burnsoftnet/Pool-Monitor/README.md

# Pool Monitor

Arduino Project to monitor PH and Temperature as well as outside temperature.  This project is put together from other Arduino Projects as well as some custom stuff that was lacking in the other projects.

## Resources:

**Pool Controller © GPL3+**

https://create.arduino.cc/projecthub/mmackes/pool-controller-8dfa69

**HOW TO SET UP THE DHT11 HUMIDITY SENSOR ON AN ARDUINO**

https://www.circuitbasics.com/how-to-set-up-the-dht11-humidity-sensor-on-an-arduino/

**Safepools.pH © LGPL**

https://create.arduino.cc/projecthub/safepools-ph/safepools-ph-408029

**DIY Benchtop pH Meter © CC BY-NC**

https://create.arduino.cc/projecthub/atlasscientific/diy-benchtop-ph-meter-e94fb4

## COMPONENTS AND SUPPLIES

- 1 x Arduino UNO Wifi Rev 2 ( https://www.amazon.com/gp/product/B07MK598QV/ref=ppx_yo_dt_b_asin_title_o08_s02?ie=UTF8&psc=1 ).
- 2 x E-Projects 10EP5144K70 4.7k Ohm Resistors, 1/4 W, 5% (Pack of 10) (https://www.amazon.com/E-Projects-4-7k-Resistors-Watt-Pieces/dp/B00EV20PF8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)
- 1 x HiLetgo 5pcs DHT11 Temperature Humidity Sensor Module Digital Temperature Humidity Sensor 3.3V-5V Humidity Measure Range 20%-95% Temperature Measure Range 0-50℃ Celsius with Dupont Wires ( https://www.amazon.com/gp/product/B01DKC2GQ0/ref=ppx_yo_dt_b_asin_title_o02_s01?ie=UTF8&psc=1 )
- 1 x Atlas Scientific Gravity Analog pH Kit
 ( https://www.amazon.com/gp/product/B07VN8SKR7/ref=ppx_yo_dt_b_search_asin_title?ie=UTF8&psc=1 )
- 1 x Gratury Junction Box, Hinged Transparent Cover Stainless Steel Clip IP67 Waterproof Plastic Enclosure for Electrical Project Includes Mounting Plate and Wall Bracket 220×170×110mm (8.6"×6.7"×4.3" TC)( https://www.amazon.com/gp/product/B0828387BM/ref=ppx_yo_dt_b_asin_title_o09_s00?ie=UTF8&psc=1 ) 
- Sunnytech 1pc 3w 9v 333ma Mini Solar Panel Module Solar System Solar Epoxy Cell Charger DIY B043 ( https://www.amazon.com/gp/product/B00P4W9UE6/ref=ppx_yo_dt_b_asin_title_o04_s00?ie=UTF8&psc=1 )
- DFROBOT 900mA MPPT Solar Panel Controller - Solar Power Manager Module for 5V Solar Panel - Support Solar and USB Charging ( https://www.amazon.com/gp/product/B07MML4YJV/ref=ppx_yo_dt_b_asin_title_o04_s01?ie=UTF8&psc=1 )
- 2pcs 3.7V 1100mAh Lithium Rechargable Battery 1S 3C Lipo Battery with Protection Board, Insulated Rubber Tape and Micro JST 1.25 Plug for Arduino Nodemcu ESP32 Development Board ( https://www.amazon.com/gp/product/B0867KDMY7/ref=ppx_yo_dt_b_asin_title_o04_s02?ie=UTF8&psc=1 )
- 1 x 10K Ohm Resistor - https://www.amazon.com/gp/product/B07QJB31M7/ref=ppx_yo_dt_b_search_asin_title?ie=UTF8&th=1
- 1 x 100k Ohm Resistor - https://www.amazon.com/gp/product/B07QK9793W/ref=ppx_yo_dt_b_search_asin_title?ie=UTF8&psc=1
- 1 x Cylewet 12Pcs 12mm Self-Locking Latching Push Button Switch - https://www.amazon.com/gp/product/B075VBV4QH/ref=ppx_yo_dt_b_search_asin_title?ie=UTF8&psc=1
- 1 x Photoresistor Photo Light Sensitive Resistor Light Dependent - https://www.amazon.com/eBoot-Photoresistor-Sensitive-Resistor-Dependent/dp/B01N7V536K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
- 1 x Waterproof Digital Temperature Sensor Single Line Smart Temperature Sensor Probe ( https://www.amazon.com/gp/product/B07VWTFZXC/ref=ppx_yo_dt_b_search_asin_title?ie=UTF8&psc=1 )
- 1 x uxcell 50 Pcs Red DIP Switch 1 Positions for Circuit Breadboards PCB ( https://www.amazon.com/gp/product/B07M9YJKQ6/ref=ppx_yo_dt_b_search_asin_title?ie=UTF8&psc=1 )
- 1 x PCB Board Prototype Board ( https://www.amazon.com/gp/product/B01N3161JP/ref=ppx_yo_dt_b_search_asin_title?ie=UTF8&psc=1 )
- 12 x Brass Standoff / Stainless Steel Screw Nut - Electronics-Salon Metric M2.5 Hex Male-Female Brass Standoff / Stainless Steel Screw Nut Assortment Kit, for Raspberry-Pi. Spacer 6mm 8mm 10mm 12mm 15mm 18mm 20mm 25mm, Nut M2.5, Screw M2.5 x 6mm.
- Jumper Wires ( https://www.amazon.com/gp/product/B08151TQHG/ref=ppx_yo_dt_b_search_asin_title?ie=UTF8&psc=1 )

## Build Cost

Below is a ruff estimate of the cost of materials to make this  pool monitor, this is not including any type of connectors or special wires that you might want to use to make it pretty or even the type of mounts to secure things in place.  But mostly a cost of all the materials listed above.

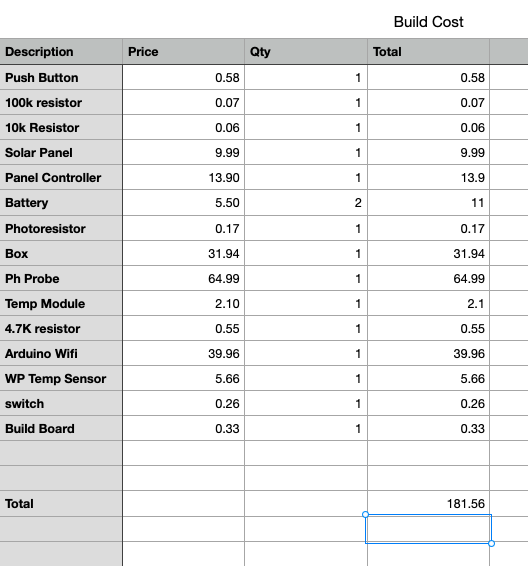
[picture p1: BuildCost.png]


## APPS AND ONLINE SERVICES

- Arduino IDE
- DallasTemperature ( https://github.com/milesburton/Arduino-Temperature-Control-Library/blob/master/DallasTemperature.h )

## Schematic

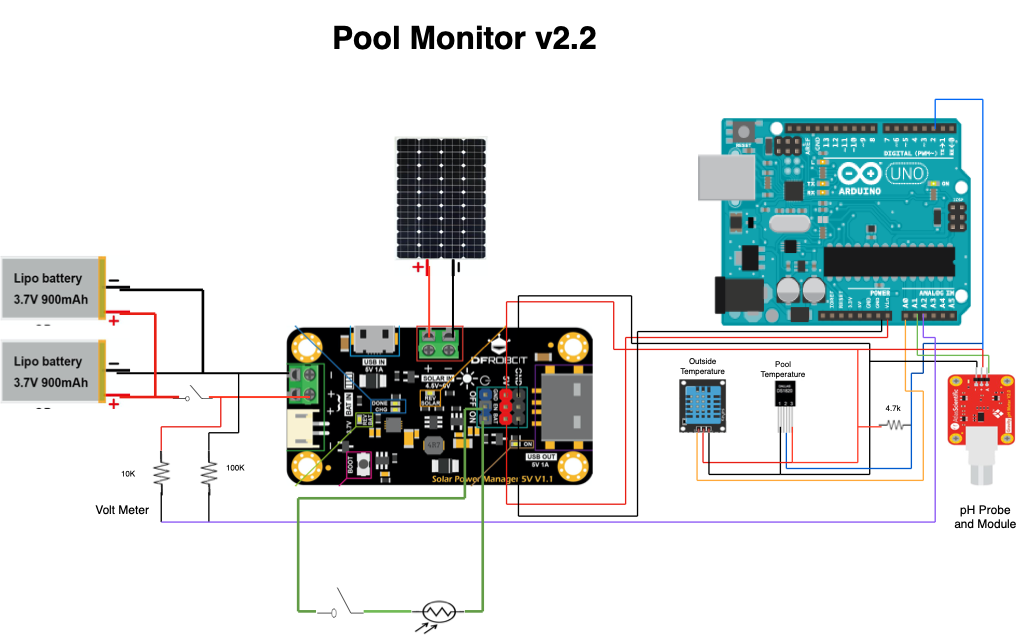
[picture p2: Schematic/PoolMonitor.png]


The Solar module and panel was added in version 2 along with a volt meter to monitor the battery status.  The Volt meter circuit has an on and off switch in case you needed to reboot everything without having to take a screw driver to it.  The Volt meter is independent and does not have to be hooked up to the Arduino, it will still pass the needed voltage to the solar module with the option to monitor the voltage from the mater.  Dis can also be disabled in the code by setting the GetVm to false.

## Web UI

There is nothing much to the web ui, it will just display the outside temperature, the outside humidity, the pool temperature and the pH Level.

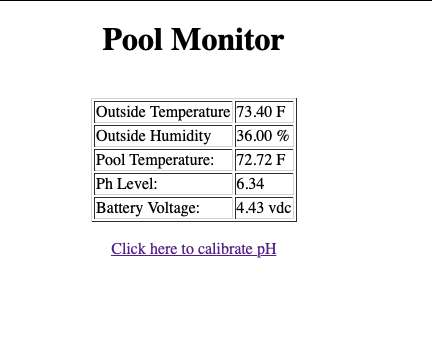
[picture p3: pictures/webui.png]


pH Calibration Page

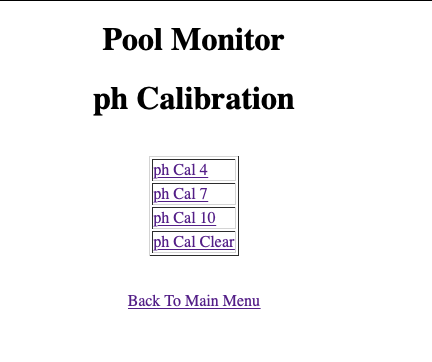
[picture p4: pictures/webui_cal.png]


## End Product

Version 2 of the finished project:

### Inside
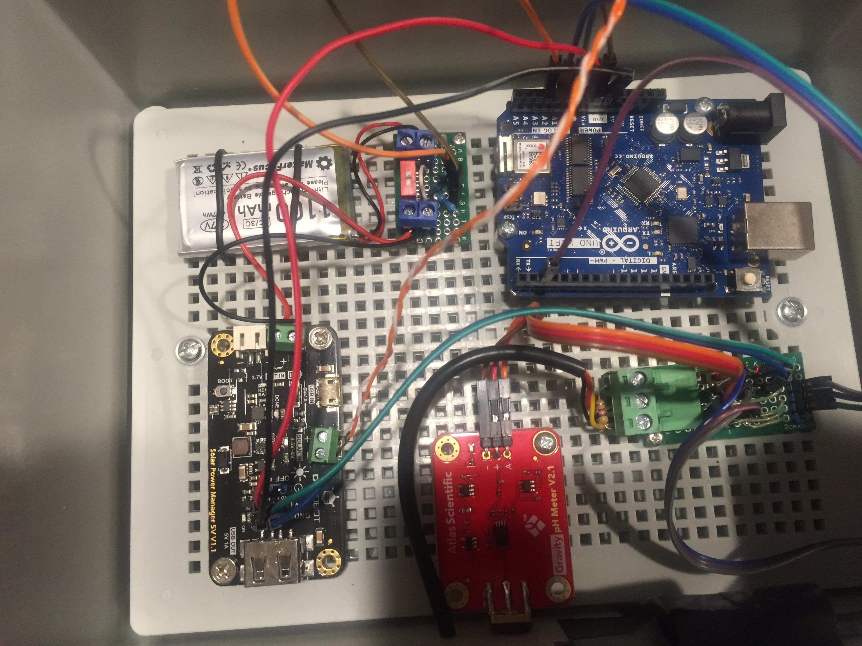
[picture p5: pictures/v2_inside.JPG]


### Outside Front

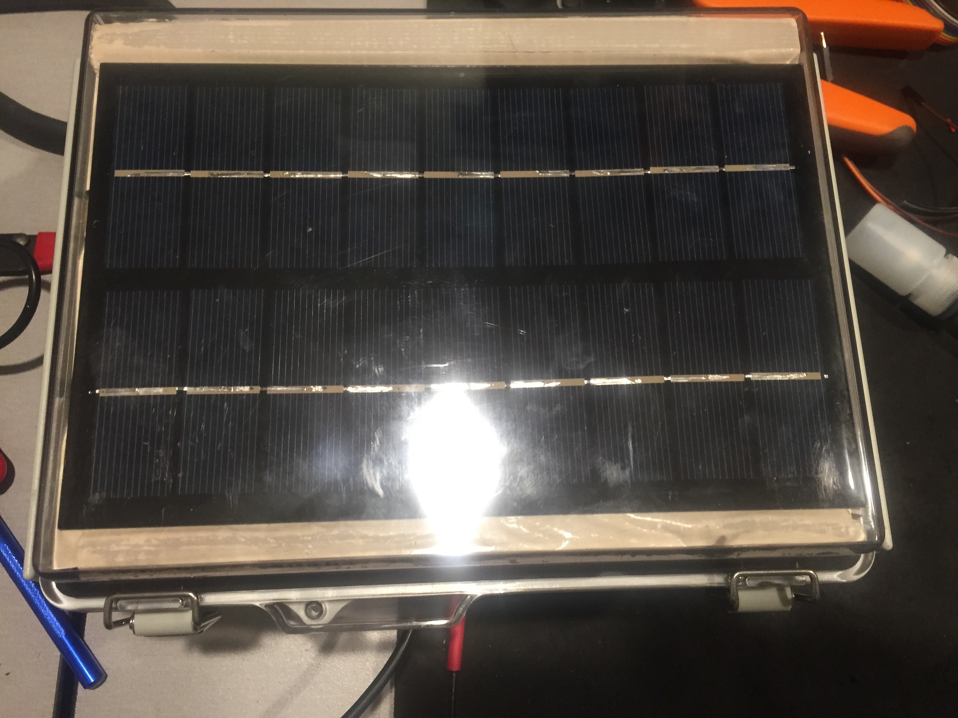
[picture p6: pictures/v2_front.JPG]


### Outside Bottom

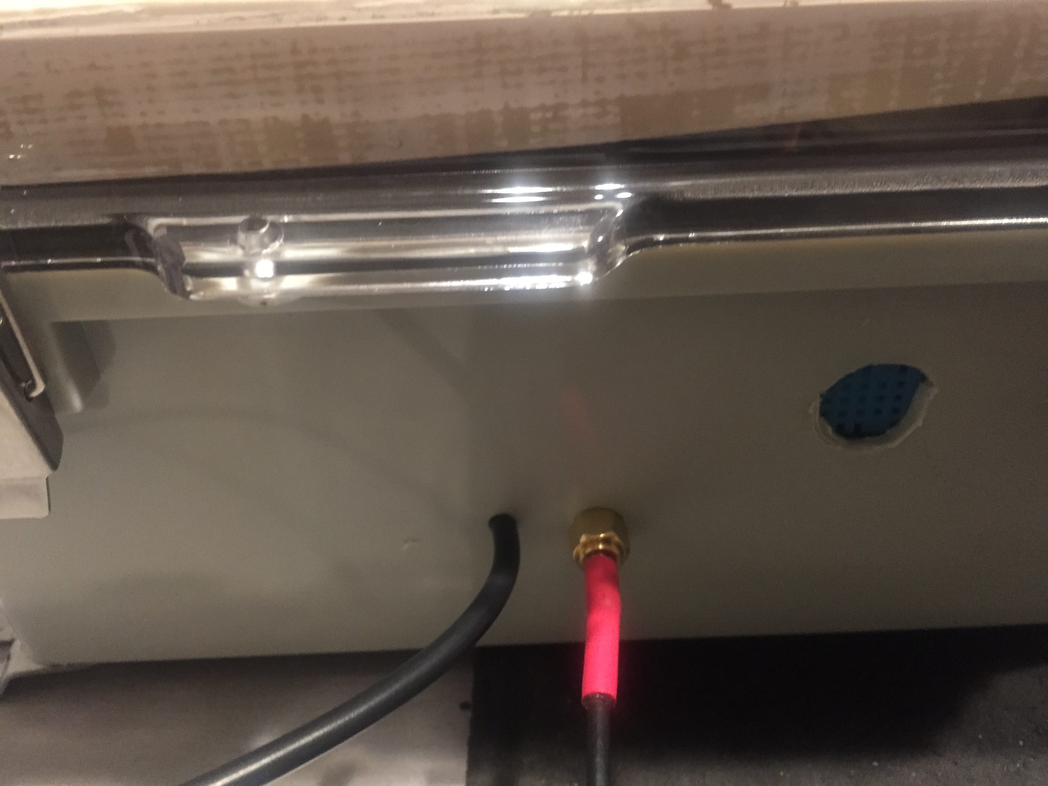
[picture p7: pictures/v2_bottom.JPG]
