burnsoftnet/Pool-Monitor/pictures/DS18B20.jpg

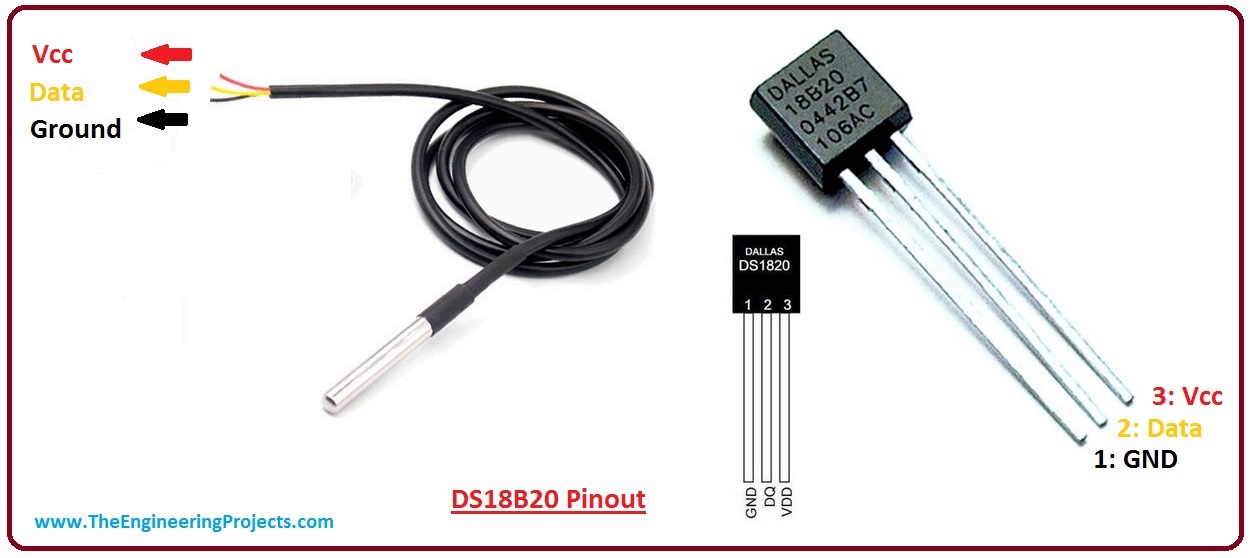
pictures/DS18B20.jpg
