burnsoftnet/Pool-Monitor/pictures/v1.JPG

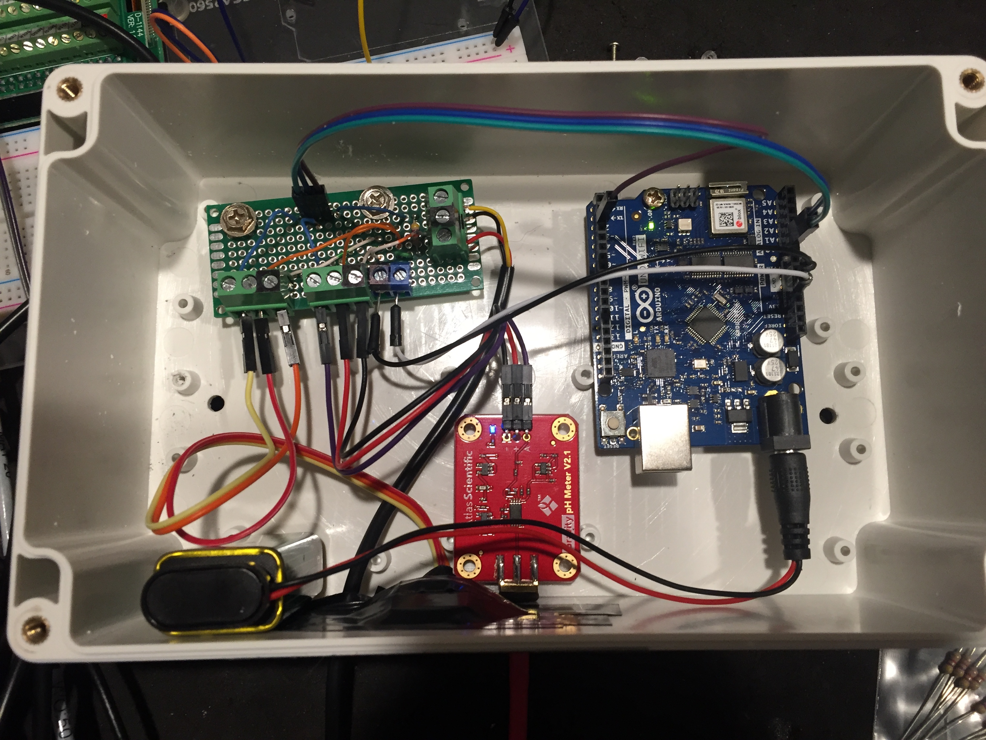
pictures/v1.JPG
