burnsoftnet/Pool-Monitor/(threads)

Thread 1 (2020-07-12):

Make Option to configure pH meter through Web UI

burnsoftnet, 2020-07-12:
Currently you can configure/ calibrate the pH meter through the serial interface, it would be better to do this through the Web UI just to reduce the amount of times that the box is opened, other than for currently the battery replacement.

Closed 2021-02-02.

Thread 2 (2020-07-12):

Update ReadMe

burnsoftnet, 2020-07-12:
Update the Read me file on everything needed to make this project:

- the final current version picture.
- Update the materials list
- Add assembly instructions

Closed 2021-01-04.

Thread 3 (2020-07-13):

Test How long the battery lasts

burnsoftnet, 2020-07-13:
This is a new battery operated project and with it controller extra functions, we need to test and see how long 1 battery would last

burnsoftnet, 2020-07-17:
Lasted for an hour after turning it back on.  going to try another batter to see if it last 7 hours straight

burnsoftnet, 2020-07-17:
Added new battery at 1640

Closed 2020-07-17.

Thread 4 (2020-07-13):

Solar Power Charger

burnsoftnet, 2020-07-13:
Add a solar power system to charge the batter when it's day light and to use the battery at night

burnsoftnet, 2020-07-23:
Mounted unit and turned on at 1740

Closed 2021-01-04.

Thread 5 (2020-07-13):

Internal Volt Meter

burnsoftnet, 2020-07-13:
Add an internal volt meter to the page so you can see how the battery is performing

Closed 2021-01-04.

Thread 8 (2021-02-04):

Increase Battery Capacity

burnsoftnet, 2021-02-04:
Increate Battery Capacity to last longer when the sun is not out

Closed 2021-02-04.

Thread 9 (2021-02-04):

Add Power and Solar Power Switch

burnsoftnet, 2021-02-04:
Add Power and Solar Power Switch to turn on and off the pool monitor

Closed 2021-02-04.

Thread 12 (2022-05-09):

Create Box for OLED

burnsoftnet, 2022-05-09:
Cut up and existing box or make something from the 3d printer

Thread 16 (2024-03-26):

Add Reset Option in Serial Menu

burnsoftnet, 2024-03-26:
Add the option to reboot the Arduino device from the serial command line.
