burnsoftnet/Pool-Monitor/ArduinoPoolMonitor/atlas_gravity/do_grav.h

/*
MIT License

Copyright (c) 2019 Atlas Scientific

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
THE SOFTWARE IS PROVIDED "AS IS", WITHOUT WARRANTY OF ANY KIND, EXPRESS OR
IMPLIED, INCLUDING BUT NOT LIMITED TO THE WARRANTIES OF MERCHANTABILITY,
FITNESS FOR A PARTICULAR PURPOSE AND NONINFRINGEMENT. IN NO EVENT SHALL THE
AUTHORS OR COPYRIGHT HOLDERS BE LIABLE FOR ANY CLAIM, DAMAGES OR OTHER
LIABILITY, WHETHER IN AN ACTION OF CONTRACT, TORT OR OTHERWISE, ARISING FROM,
OUT OF OR IN CONNECTION WITH THE SOFTWARE OR THE USE OR OTHER DEALINGS IN THE
SOFTWARE
*/

#ifndef DO_GRAV_H
#define DO_GRAV_H

#if ARDUINO >= 100
#include "Arduino.h"
#else
#include "WProgram.h"
#endif

class Gravity_DO{
	public:
	
		Gravity_DO(uint8_t pin);
		
		bool begin();
	
		float read_voltage();
		float read_do_percentage(float voltage_mV);
		float read_do_percentage();
        
        float cal();
        float cal_clear();
		
	private:
	
		uint8_t pin = A1;
		
		static const int volt_avg_len = 1000;

		static const uint8_t magic_char = 0xAA;
		
        static const float DEFAULT_SAT_VOLTAGE = (40.0*11.0);
		struct DO {
		  const uint8_t magic = magic_char;
		  float full_sat_voltage = DEFAULT_SAT_VOLTAGE;
		};
		struct DO Do;
};

#endif
