burnsoftnet/Pool-Monitor/ArduinoPoolMonitor/atlas_gravity/Examples/do_grav_example/do_grav_example.ino

#include "do_grav.h"

Gravity_DO DO = Gravity_DO(A0);

uint8_t user_bytes_received = 0;
const uint8_t bufferlen = 32;
char user_data[bufferlen];


void parse_cmd(char* string) {
  strupr(string);
  String cmd = String(string);
  if(cmd.startsWith("CAL")){
    int index = cmd.indexOf(',');
    if(index != -1){
      String param = cmd.substring(index+1, cmd.length());
      if(param.equals("CLEAR")){
        DO.cal_clear();
        Serial.println("CALIBRATION CLEARED");
      }
    }
    else{
      DO.cal();
      Serial.println("DO CALIBRATED");
    }
  }
}

void setup() {
  Serial.begin(9600);
  delay(200);
  Serial.println(F("Use command \"CAL\" to calibrate the circuit to 100% saturation in air\n\"CAL,CLEAR\" clears the calibration"));
  if(DO.begin()){
    Serial.println("Loaded EEPROM");
  }
}

void loop() {
  if (Serial.available() > 0) {
    user_bytes_received = Serial.readBytesUntil(13, user_data, sizeof(user_data));
  }

  if (user_bytes_received) {
    parse_cmd(user_data);
    user_bytes_received = 0;
    memset(user_data, 0, sizeof(user_data));
  }
  
  Serial.println(DO.read_do_percentage());
  delay(1000);
}
