burnsoftnet/Pool-Monitor/ArduinoPoolMonitor/atlas_gravity/Examples/pH_grav_example/pH_grav_example.ino

#include "ph_grav.h"                           

Gravity_pH pH = Gravity_pH(A0);                     

uint8_t user_bytes_received = 0;                
const uint8_t bufferlen = 32;                   
char user_data[bufferlen];                     

void parse_cmd(char* string) {                   
  strupr(string);                                
  if (strcmp(string, "CAL,7") == 0) {       
    pH.cal_mid();                                
    Serial.println("MID CALIBRATED");
  }
  else if (strcmp(string, "CAL,4") == 0) {            
    pH.cal_low();                                
    Serial.println("LOW CALIBRATED");
  }
  else if (strcmp(string, "CAL,10") == 0) {      
    pH.cal_high();                               
    Serial.println("HIGH CALIBRATED");
  }
  else if (strcmp(string, "CAL,CLEAR") == 0) { 
    pH.cal_clear();                              
    Serial.println("CALIBRATION CLEARED");
  }
}

void setup() {
  Serial.begin(9600);                            
  delay(200);
  Serial.println(F("Use commands \"CAL,7\", \"CAL,4\", and \"CAL,10\" to calibrate the circuit to those respective values"));
  Serial.println(F("Use command \"CAL,CLEAR\" to clear the calibration"));
  if (pH.begin()) {                                     
    Serial.println("Loaded EEPROM");
  }
}

void loop() {
  if (Serial.available() > 0) {                                                      
    user_bytes_received = Serial.readBytesUntil(13, user_data, sizeof(user_data));   
  }

  if (user_bytes_received) {                                                      
    parse_cmd(user_data);                                                          
    user_bytes_received = 0;                                                        
    memset(user_data, 0, sizeof(user_data));                                         
  }
  
  Serial.println(pH.read_ph());                                                      
  delay(1000);
}
