burnsoftnet/Pool-Monitor/(commit log)

2020-07-12 Updated Readme with materials and references
2020-07-12 Adding touch draw schematic
2020-07-12 Added picture of water proof temperature sensor
2020-07-12 Updated schematic
2020-07-12 Added Dallas Temperature Module
2020-07-12 Added information about the ph monitoring section and materials
2020-07-12 Updated schematic picture
2020-07-12 Updated readme image with schematic
2020-07-12 Removed DallasTemperature modules from eh internet and installed the ones from the Arduino IDE,
2020-07-12 Included Libraries for the Dallas Temperature module
2020-07-12 Attempted not to use the Dallas module, but temperature didn't work putting back in module and added comments
    [PoolMonitor.ino]
2020-07-12 Added current Dallas module
2020-07-14 Reduced the serial prints to maybe help with poor usage by making it a double option, first the debug messages enabled.disabled, and if enabled then print is serial available.
2020-07-16 #6 Reverted back to original code, caused the board to be unresponsive
    [PoolMonitor.ino]
2020-07-17 #6 Fixed code after verification
    [PoolMonitor.ino]
2020-07-22 32 Updated schematic for read me
2020-07-22 #2 Updated pool Schematic
2020-07-23 #5 Added the ability to use a volt meter for the battery monitoring
2020-07-23 #5 Added quick fix on volt meter by need to figure out why this is not working when it works for other things
    [PoolMonitor.ino]
2020-07-24 #2 Updated schematic drawing
2020-07-24 #2 added description to schematic on the new additions from version 1
2020-07-24 #2 Added link to the arduino wifi rev 2
2021-02-02 #1 Added Section of webpage for pool calibration
2021-02-02 #1 working on parsing client.read to get ph switch
2021-02-02 #1 Have the ability to switch between the regular and the calibration page
2021-02-02 #1 Completed web page section and links to calibrate the pH monitor with low, high, mid or clear
2021-02-04 #8 Increased batter capacity by putting batteries in parallel.
2021-02-04 #9 Added Manual Switch and photocell to schematic to manually shut it all down or have the photo cell do it at night.
2021-02-04 Added Build Cost Summary and updated read me with build materials
